RajShah-1/Balance-Bot/README.md

# Objective

The objective is to make a remote control robot capable of balancing itself using Linear Quadratic Regulator (LQR) Control.

# Components
- Arduino Mega
- MPU 6050 (Accelerometer+Gyroscope)
- DC Motors with quadrature encoders
- Xbee Module 
- Motor Driver (L298N)
- 12V Lipo Battery
- Chassis
- Breadboard
- Wheels

# Status
Currently, the bot can balance on two-wheel. We're tuning the parameters to improve the balance. 
We are also working on the Xbee based remote parallelly.

# 3D Model of Chassis
- 3D Modelling of robot is done in solidworks, and those files are available in 3D Model folder.
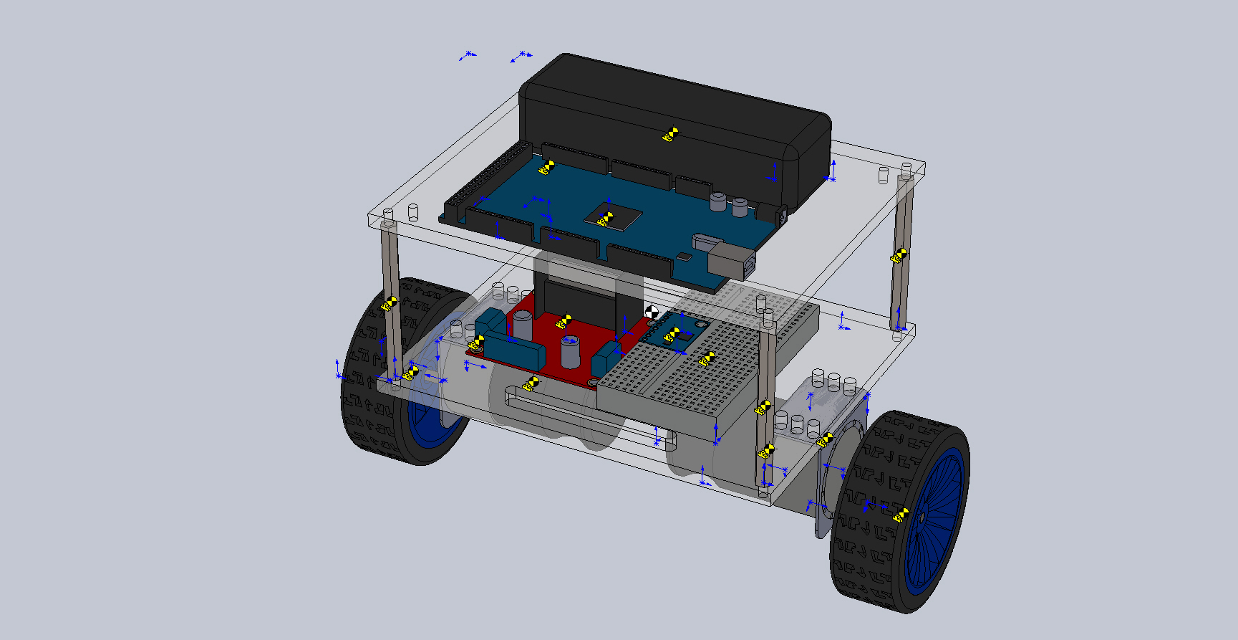
[picture p1: images/model.JPG]


# Mathematical Model
- Derivations are given in the folder Mathematical Model.
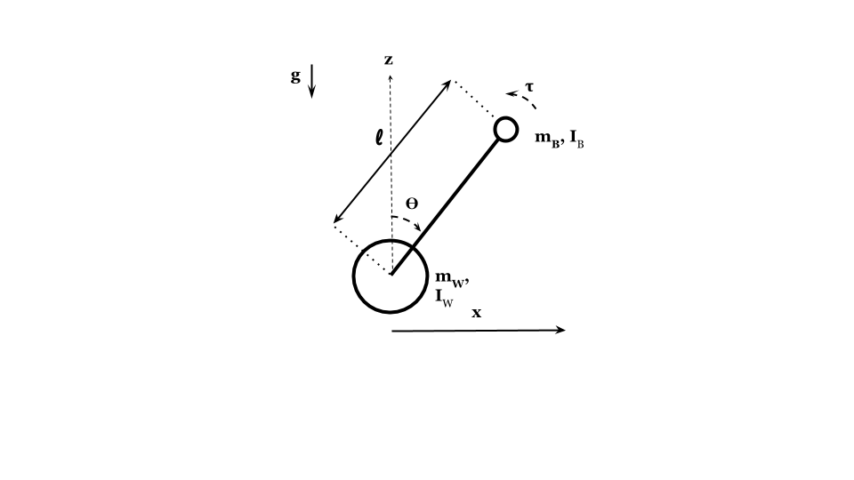
[picture p2: images/Model.png]


- State-Space Equation
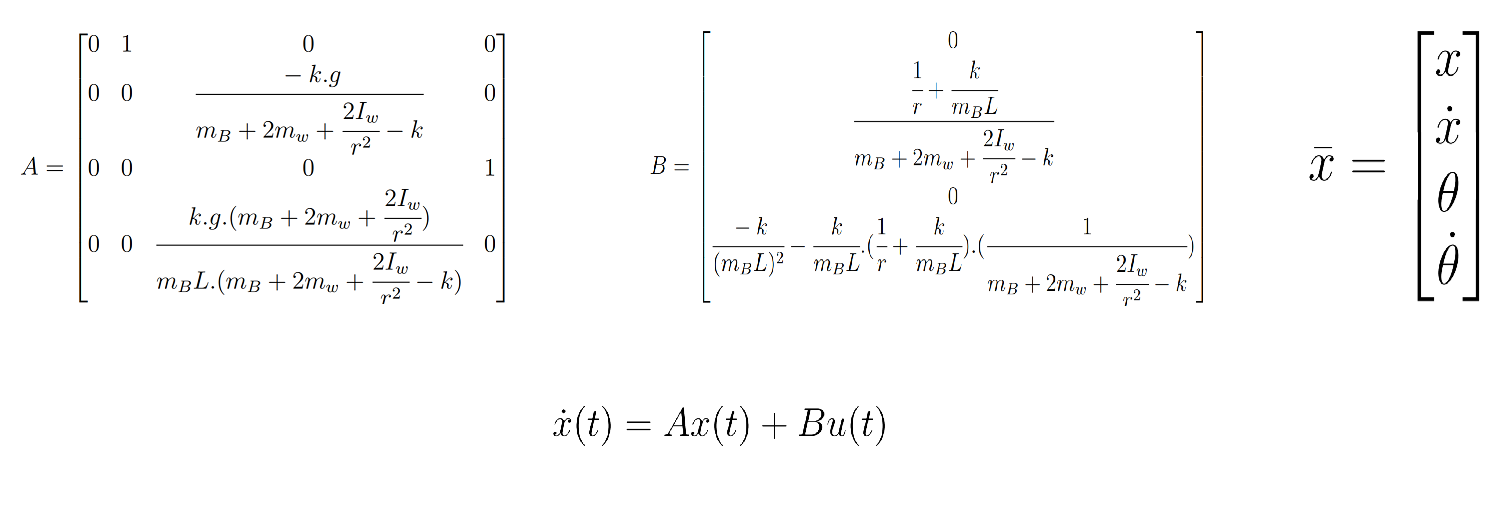
[picture p3: images/StateSpaceEquation.png]


# Complementary Filter
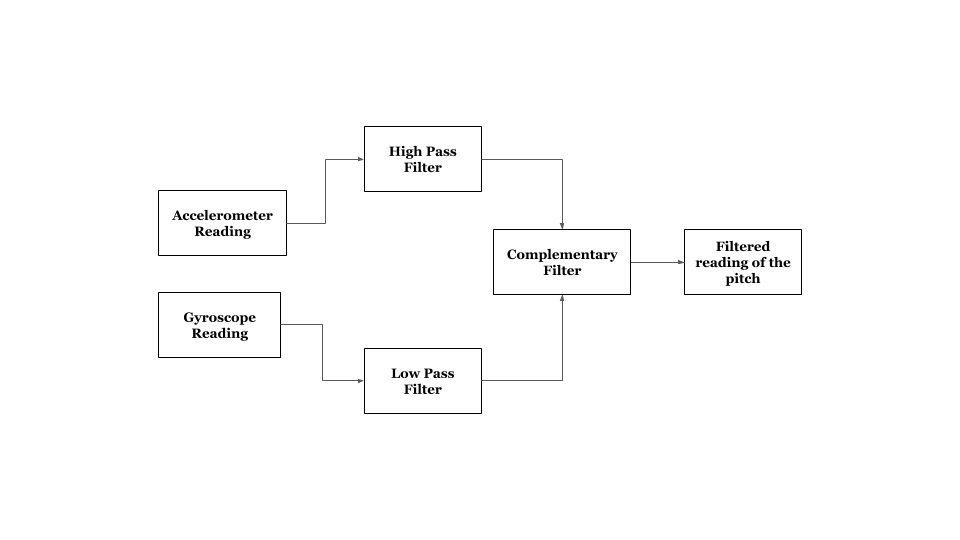
[picture p4: images/filters.png]


# Control Architecture
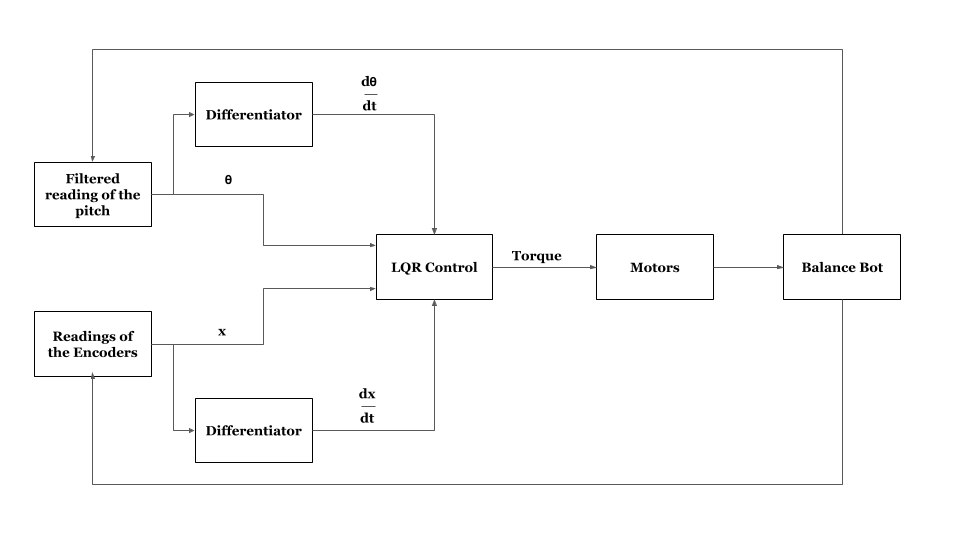
[picture p5: images/ControlArchitecture.png]


# Code Structure

## main.ino
- This is the file in which code for controlling Arduino Mega is written.

## Encoders
- In these files, class of encoders is defined.  
- X4 encoding is used.

## Motor
- In these files, class of motor is defined.
- Each motor object has an encoder attribute.

## TimerInterruptsLib
- Timers 3, 4, and 5 are initialized in this library.

## RCModule
- In this files, class of Xbee is defined.

# Requirements
- Arduino IDE
  - digitalWriteFast.h
  - MPU6050
  - MPULib
  - I2C
  - I2Cdev
  
- Octave
  - "control"  and "symbolic" package
