RajShah-1/Balance-Bot/Mathematical Model/Balance_Bot_Mathematical_Modelling.pdf

# Mathematical Modelling

mB = Mass of the body
mw = Mass of the wheel
IB = Moment of inertia of the body about the axis of wheels
Iw = Moment of inertia of the wheel
L = Height of the centre of mass of the body from the centre of the wheels r = Radius of the wheels
T = Torque due to both the wheels

φ = The angular velocity of the wheel about its axis of rotation. x = Position of centre of mass of wheel along x-axis
x˙ = Linear velocity of centre of mass of the wheel
θ = Angle between z-axis and body of the robot
˙θ = Angular velocity of the body

Ek = Kinetic Energy
Ep = Potential Energy with the plane through centre of mass of wheels as reference

Assuming the motion of wheels to be pure rolling
x = rφ

φ˙ =

x˙
r

Derivation

Ek = (mw +

mB
2

+

Iw
r

2

)( ˙x)

2 +

(mBL

2 + IB)

2

(

˙θ)

2 + mBL ˙θx˙ cos(θ)

Ep = mBgL cos(θ)

L = Ek − Ep = (mw +

mB
2

+

Iw
r

2

)( ˙x)

2 +

(mBL

2 + IB)

2

(

˙θ)

2 + mBL ˙θx˙ cos(θ) − mBgL cos(θ)

∂L
∂θ = mBL sin(θ)(g − ˙θx˙)

d
dt(

∂L
∂

˙θ

) = (mBL

2 + IB)

¨θ + mBLx¨ cos(θ) − mBLx˙

˙θ sin(θ)

∂L
∂x = 0

d
dt(

∂L
∂

˙θ

) = (mB + 2mw + 2

Iw
r

2

)¨x + mBL¨θ cos(θ) − mBL ˙θ
2
sin(θ)

1

By Euler-Lagrange Equation Q = Generalised Force
q = Generalised Co-ordinates d
dt(

∂L
∂q˙

) −

∂L
∂q = Q

Equations of Motion

¨θ =

mBgL sin(θ) − mBLx¨ cos(θ) − T (mBL² + IB)

(mB + 2mw + 2

Iw
r

2

)¨x + mBL¨θ cos(θ) − mBL ˙θ
2
sin(θ) =

T
r

For sake of simplicity let’s take k =

m²
BL

2
mBL² + IB
From Equations of Motion

x¨ =

1

mB + 2mw +

2Iw
r

2

− kcos(θ)

2

.(−k.g.cos(θ).sin(θ) + mBL

2 ˙θ
2
sin(θ) + (

1
r

+

k.cos(θ)
mBL

).T)

x¯ =

x
x˙
θ
˙θ

By solving x¯˙ = f(¯x) = 0 the equilibrium point we get are :

x
0
0
0

(Unstable),

x
0
π
0

(Stable)

Here x (first element of x¯) is free to take any value.

Let’s x¯o =

x
0
0
0

(Unstable Equilibrium)

Linearising x¯˙ = f(¯x) about x¯o ∂x¨
∂x(at x¯o) = 0

∂x¨
∂x˙

(at x¯o) =

1

mB + 2mw +

2Iw
r

2

− k

.0 = 0

2

∂
x¨
∂θ

(at

x¯o) =

1

m

B + 2

m
w

+

2

### Iwr²

−

k.(

−k.g

)

∂
x¨
∂ ˙θ

(at

x¯o) =

1

m

B + 2

m
w

+

2

### Iwr²

−

k.0 = 0

∂
x¨
∂T

(at

x¯o) =

1r
+

k
m
B

L

m

B + 2

m
w

+

2

### Iwr²

−
k

¨θ
=

k.g.sin

(
θ

)
m
B

L

−

k.x.cos ¨

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
x¯o) = 0

∂

¨θ

∂

x˙(at

x¯o) = 0

∂

¨θ

∂θ

(at

x¯o) =

k.g mBL. m

B + 2

m
w

+

2

### Iwr²

m

B + 2

m
w

+

2

### Iwr²

−
k

∂

¨θ

∂ ˙θ

(at

x¯o) = 0

∂

¨θ

∂T

(at

x¯o) =

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
). | 1 mB + 2mw

+

2

### Iwr²

−
k

A
=
0 1 | 0 | 0
0 0 | − k.g

m

B + 2

m
| w

+

2

### Iwr²

−
k
| | 0
0 0 | 0 | 1

0 0

k.g.

(
m
| B + 2

m
w

+

2

### Iwr²

)

m

BL.

(
m
| B + 2 m
w

+

2

### Iwr²

−
k

)

| | 0

3

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
