RajShah-1/Balance-Bot/3D Model/Balance Bot/Bot.SLDASM

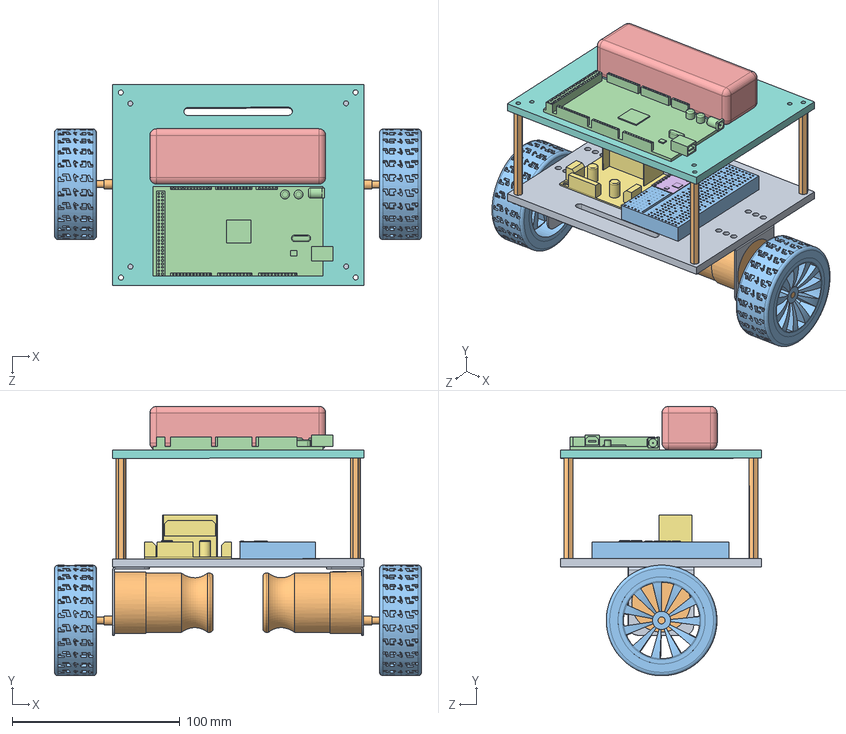
[picture p6: CAD file, 2020-03-03]
3D Model/Balance Bot/Bot.SLDASM
219.1 x 160.8 x 120.1 mm
Motor clamp x 2
Motor x 2
Wheel x 2
Arduino Mega
Battery
GY87
Motor driver
MidPlate
BottomPlate
Rod(6) x 4
Breadboard
