RajShah-1/Balance-Bot/3D Model/Balance Bot/Motor.SLDPRT

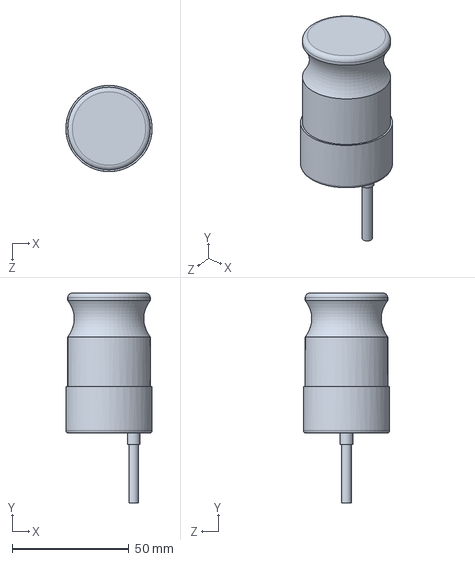
[picture p7: CAD file, 2020-03-03]
3D Model/Balance Bot/Motor.SLDPRT
37.0 x 90.0 x 37.0 mm
