RajShah-1/Balance-Bot/3D Model/Balance Bot/Electromagnet.SLDPRT

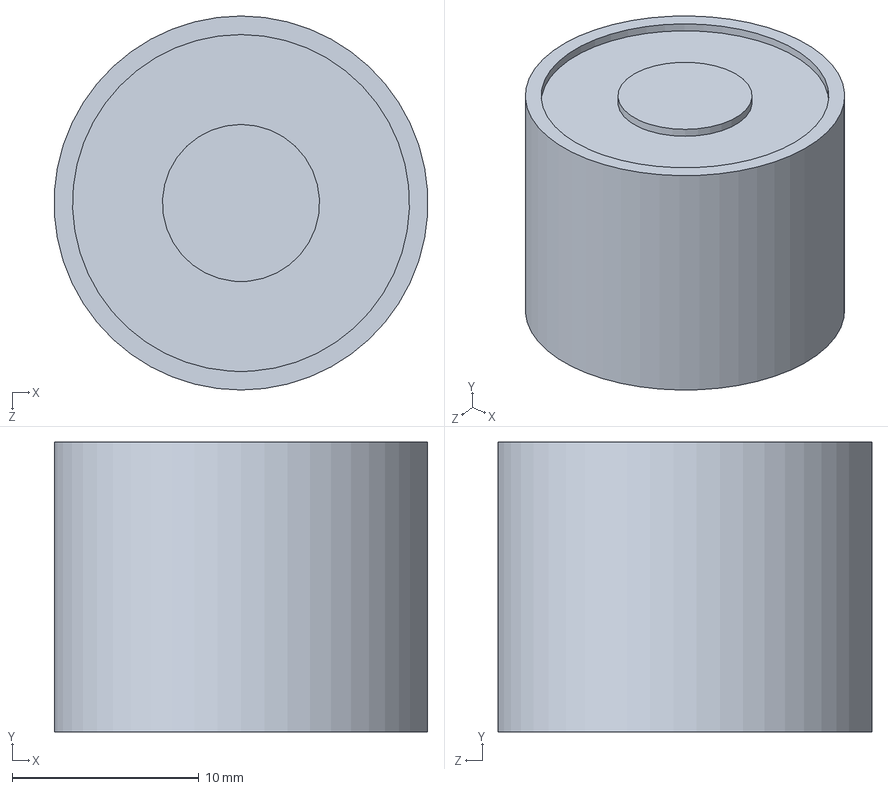
[picture p8: CAD file, 2020-03-03]
3D Model/Balance Bot/Electromagnet.SLDPRT
20.0 x 15.5 x 20.0 mm
