RajShah-1/Balance-Bot/3D Model/Balance Bot/BottomPlate.SLDPRT

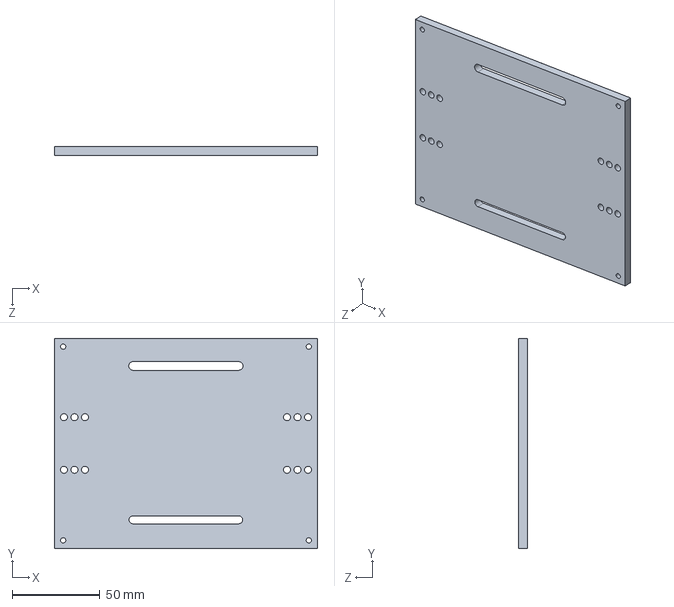
[picture p9: CAD file, 2020-03-03]
3D Model/Balance Bot/BottomPlate.SLDPRT
150.0 x 120.0 x 5.00 mm
