RajShah-1/Balance-Bot/3D Model/Balance Bot/Rod(5).SLDPRT

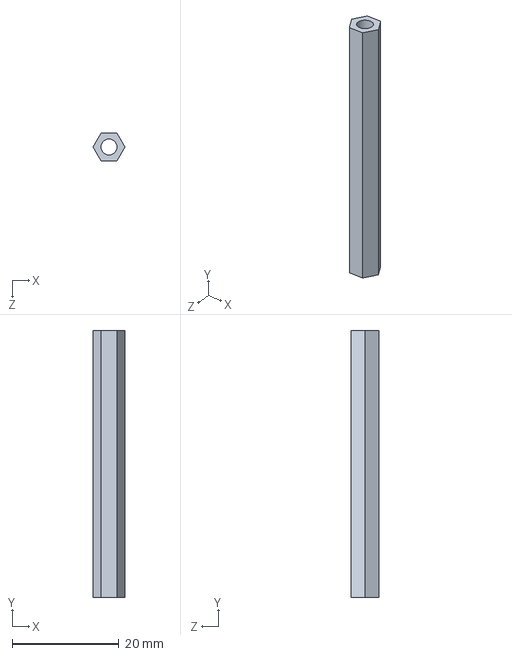
[picture p10: CAD file, 2020-03-03]
3D Model/Balance Bot/Rod(5).SLDPRT
6.00 x 50.0 x 5.20 mm
