RajShah-1/Balance-Bot/3D Model/Balance Bot/GY87.SLDPRT

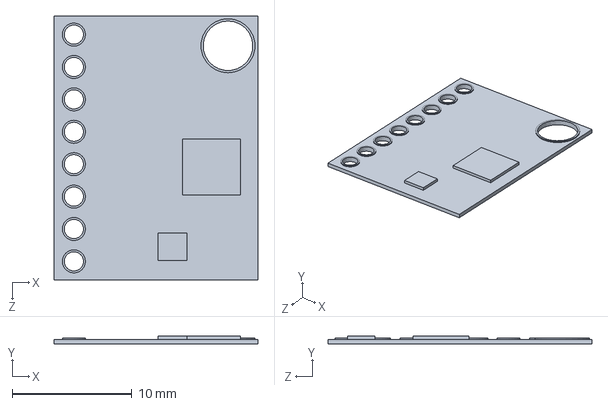
[picture p11: CAD file, 2020-03-03]
3D Model/Balance Bot/GY87.SLDPRT
17.0 x 0.7 x 22.0 mm
