RajShah-1/Balance-Bot/3D Model/Balance Bot/Motor driver.SLDPRT

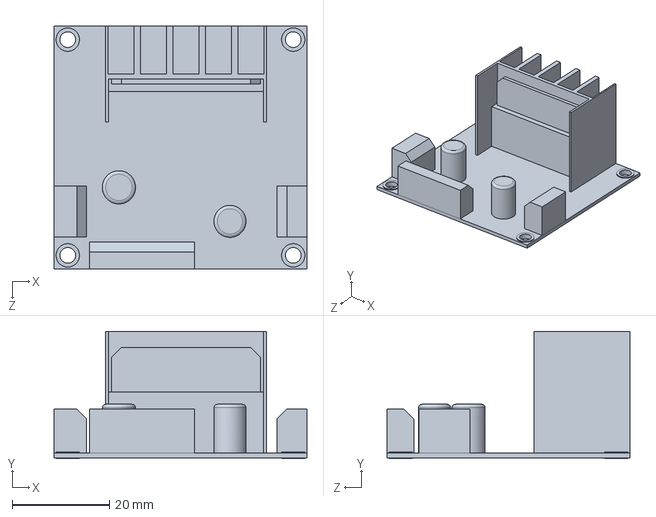
[picture p12: CAD file, 2020-03-03]
3D Model/Balance Bot/Motor driver.SLDPRT
52.0 x 26.2 x 50.0 mm
