RajShah-1/Balance-Bot/3D Model/Balance Bot/Arduino Mega.SLDPRT

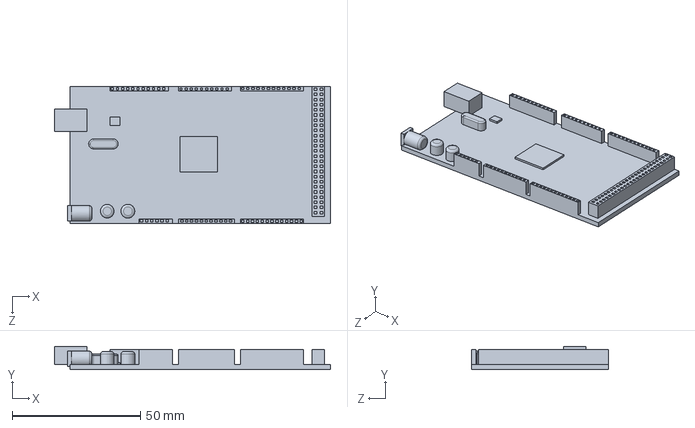
[picture p13: CAD file, 2020-03-03]
3D Model/Balance Bot/Arduino Mega.SLDPRT
107.5 x 9.00 x 53.3 mm
