RajShah-1/Balance-Bot/3D Model/Balance Bot/Buzzer.SLDPRT

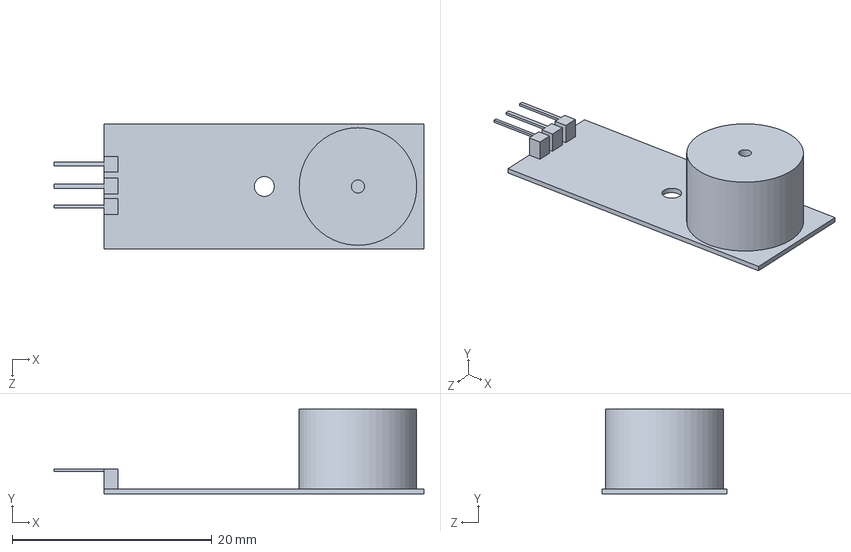
[picture p14: CAD file, 2020-03-03]
3D Model/Balance Bot/Buzzer.SLDPRT
37.0 x 8.50 x 12.5 mm
