RajShah-1/Balance-Bot/3D Model/Balance Bot/Motor clamp.SLDPRT

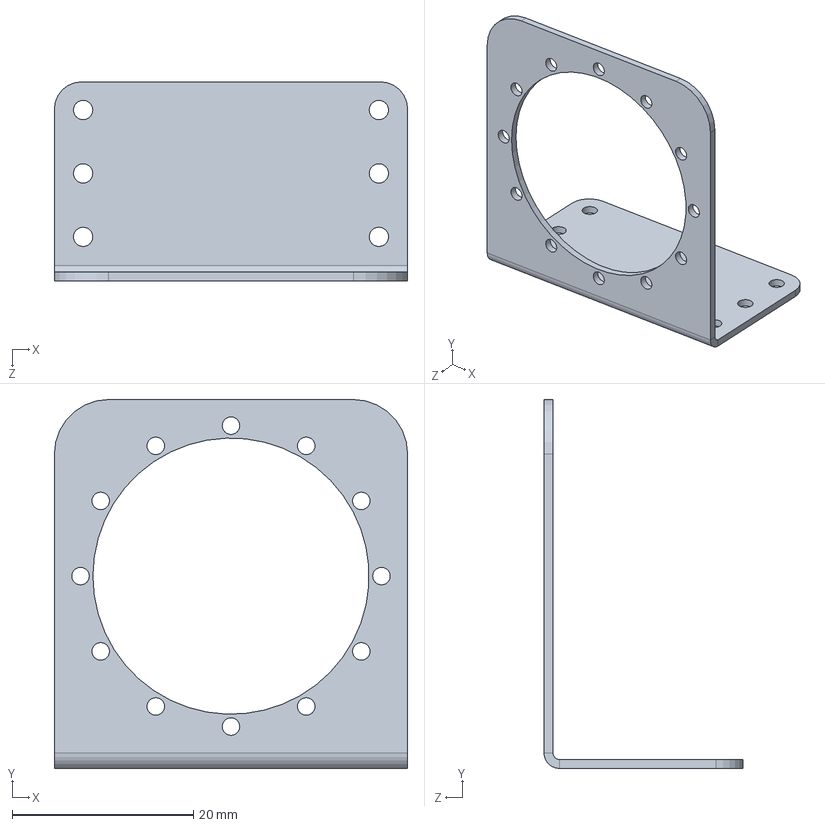
[picture p15: CAD file, 2020-03-03]
3D Model/Balance Bot/Motor clamp.SLDPRT
39.0 x 40.7 x 22.0 mm
