RajShah-1/Balance-Bot/3D Model/Balance Bot/Rod(6).SLDPRT

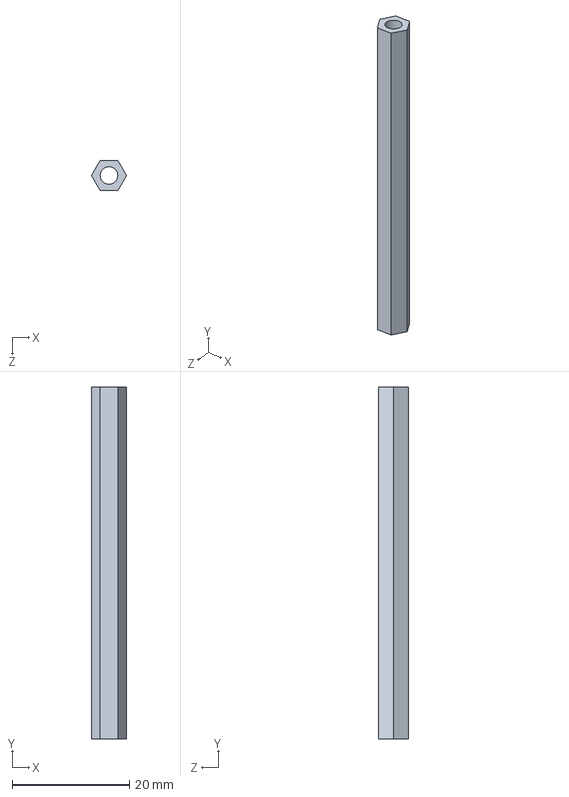
[picture p16: CAD file, 2020-03-03]
3D Model/Balance Bot/Rod(6).SLDPRT
6.00 x 60.0 x 5.20 mm
