RajShah-1/Balance-Bot/3D Model/Balance Bot/IRF540N.SLDPRT

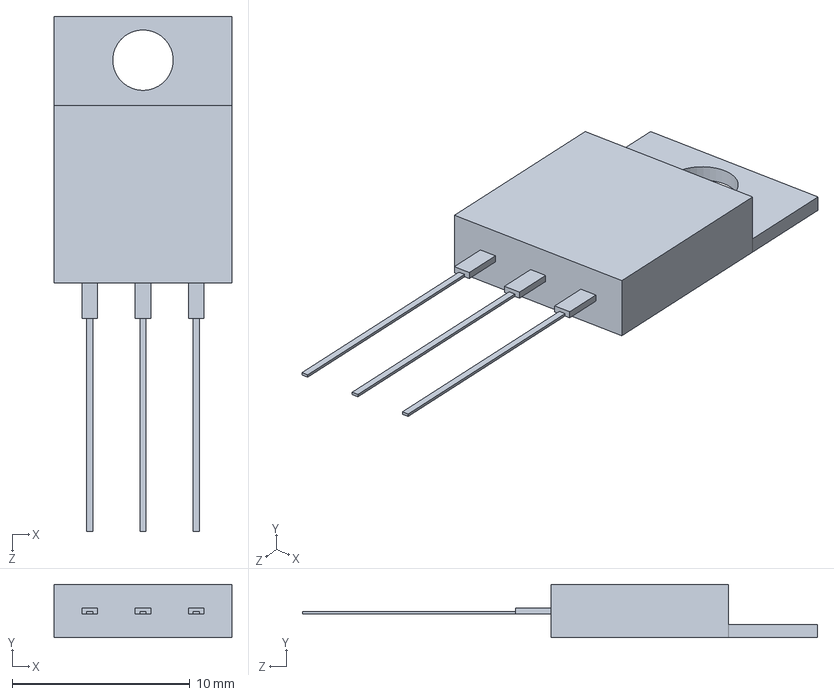
[picture p17: CAD file, 2020-03-03]
3D Model/Balance Bot/IRF540N.SLDPRT
10.0 x 3.00 x 29.0 mm
