RajShah-1/Balance-Bot/3D Model/Balance Bot/Xbee.SLDPRT

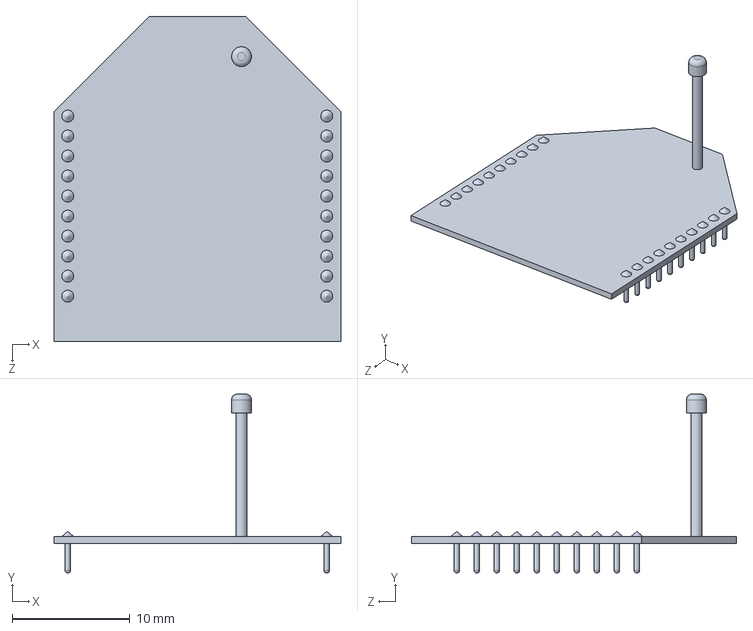
[picture p18: CAD file, 2020-03-03]
3D Model/Balance Bot/Xbee.SLDPRT
24.4 x 15.2 x 27.6 mm
