RajShah-1/Balance-Bot/3D Model/Balance Bot/Wheel.SLDPRT

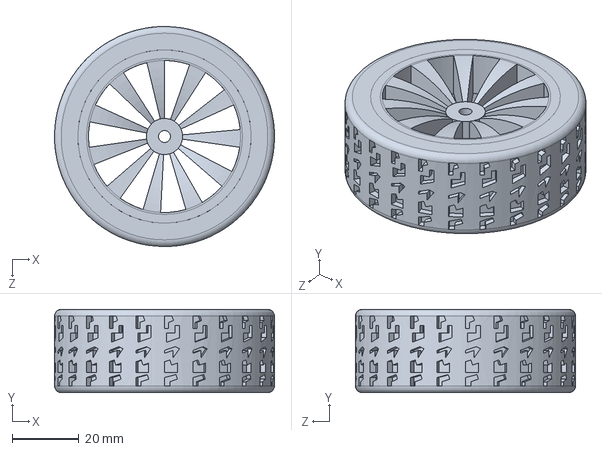
[picture p19: CAD file, 2020-03-03]
3D Model/Balance Bot/Wheel.SLDPRT
66.0 x 25.0 x 66.0 mm
