RajShah-1/Balance-Bot/3D Model/Balance Bot/LED.SLDPRT

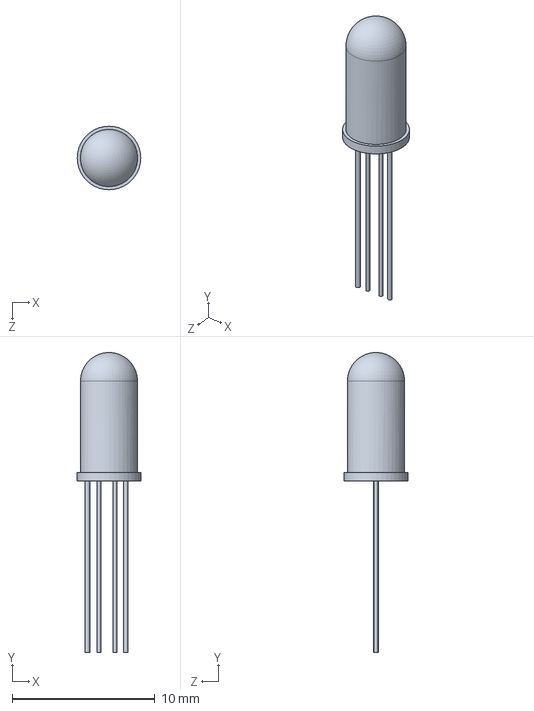
[picture p20: CAD file, 2020-03-03]
3D Model/Balance Bot/LED.SLDPRT
4.45 x 21.0 x 4.45 mm
