RajShah-1/Balance-Bot/3D Model/Balance Bot/Breadboard.SLDPRT

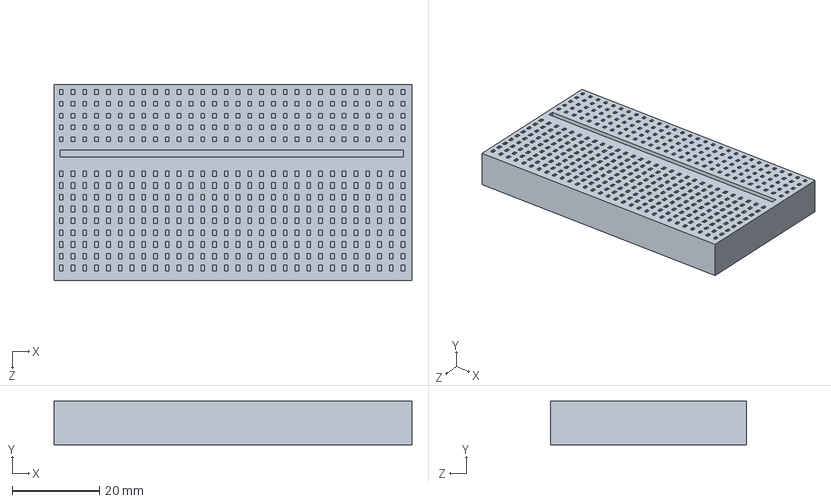
[picture p21: CAD file, 2020-03-03]
3D Model/Balance Bot/Breadboard.SLDPRT
82.0 x 10.0 x 45.0 mm
