RajShah-1/Balance-Bot/3D Model/Balance Bot/Battery.SLDPRT

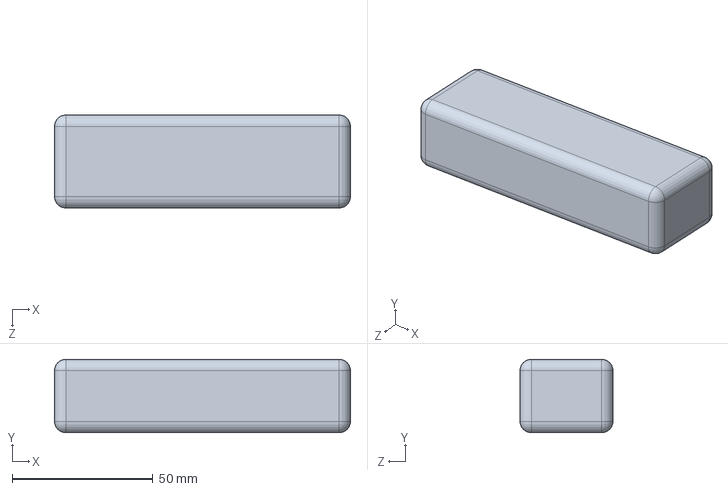
[picture p22: CAD file, 2020-03-03]
3D Model/Balance Bot/Battery.SLDPRT
105.0 x 26.0 x 33.0 mm
