RajShah-1/Balance-Bot/(list of files, cad)

Other CAD files:
3D Model/Balance Bot/TopPlate.SLDPRT
3D Model/Balance Bot/MidPlate.SLDPRT
