RajShah-1/Balance-Bot/(commit log)

2019-11-10 Added existing code
    [output_data.csv, sensor_data.csv]
2019-11-26 Added Task 1.2 Practical
    [csv_matter.csv, csv_output.csv]
2020-02-01 Changed the file structure in the repo
    [csv_matter.csv, csv_output.csv, output_data.csv]
2020-02-01 Added encoders and motor libraries
2020-02-06 Increased resolution of torque in motor library
2020-02-07 Deleted old trials and libraries
    [csv_matter.csv, csv_output.csv, output_data.csv]
2020-02-07 Updated motor libraries(Now working :) )
2020-02-08 Added TimerInterrupt Code
2020-02-08 Added timerInterrupts library
2020-02-09 I2cWithISR2 is what you want : )
2020-02-09 Integrated timer-interrupts with lqr code
2020-02-09 Added I2C lib.
2020-02-09 Added PID sletch
2020-03-03 Added 3d model and images of the balance bot
    [Arduino Mega.SLDPRT, Battery.SLDPRT, Bot.SLDASM, BottomPlate.SLDPRT, Breadboard.SLDPRT, Buzzer.SLDPRT, Electromagnet.SLDPRT, GY87.SLDPRT]
2020-03-04 Updated complementary filter diagram
2020-03-05 Added current status of the project
